yeyixin20041209-png/ESIprojectgroup5/3D/palm.stl

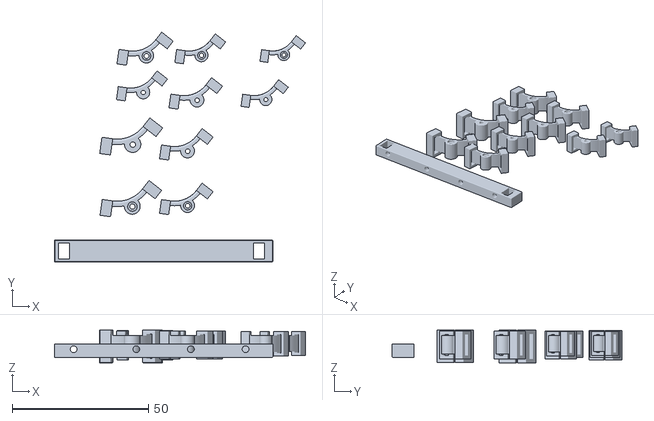
[picture p1: CAD file, 2026-11-02]
3D/palm.stl
92.0 x 84.2 x 12.0
