yeyixin20041209-png/ESIprojectgroup5/motor base for nema-17.stl

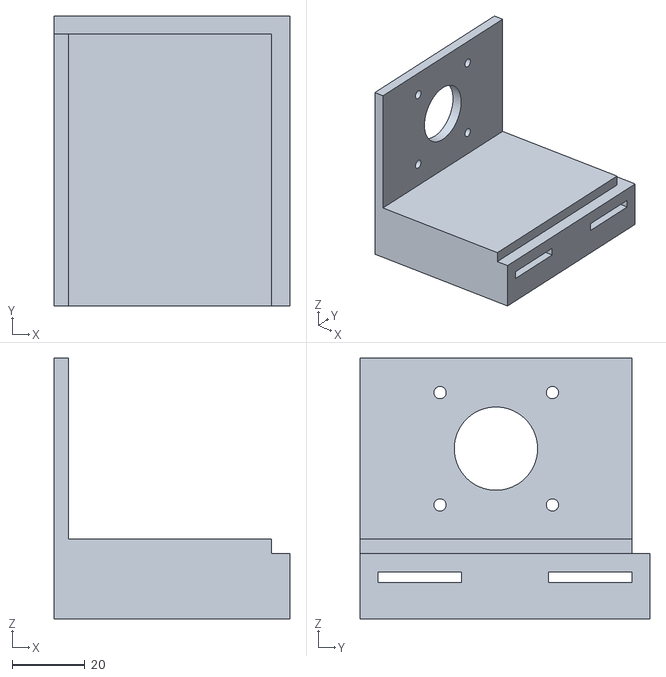
[picture p2: CAD file, 2026-11-02]
motor base for nema-17.stl
65.0 x 80.0 x 72.0
