yeyixin20041209-png/ESIprojectgroup5/spool.stl

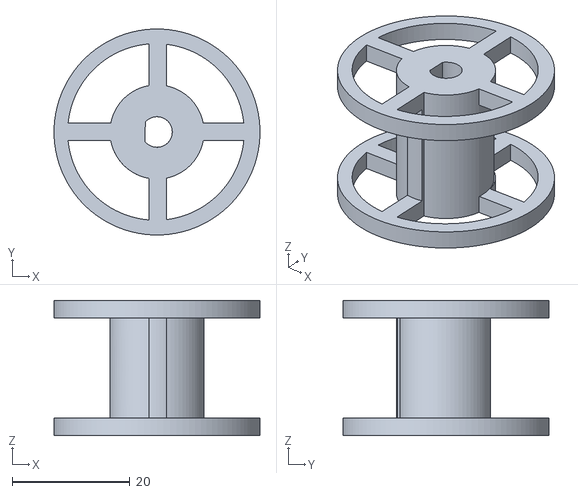
[picture p3: CAD file, 2026-11-02]
spool.stl
35.0 x 35.0 x 23.0
