yeyixin20041209-png/ESIprojectgroup5/battery base.stl

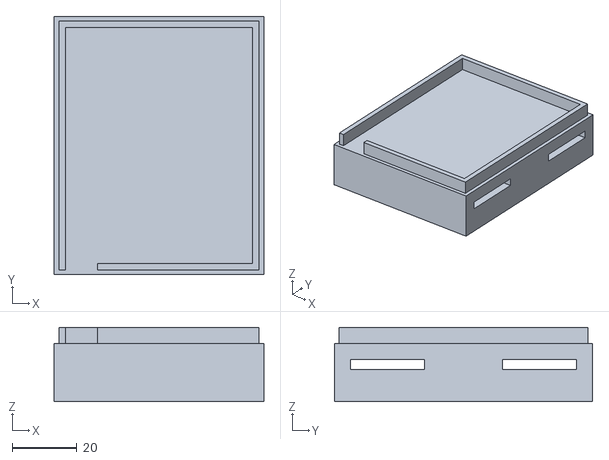
[picture p4: CAD file, 2026-11-02]
battery base.stl
65.0 x 80.0 x 23.0
