yeyixin20041209-png/ESIprojectgroup5/pcb/project.kicad_sch

## KiCad design pcb/project.kicad_sch (2026-11-02)

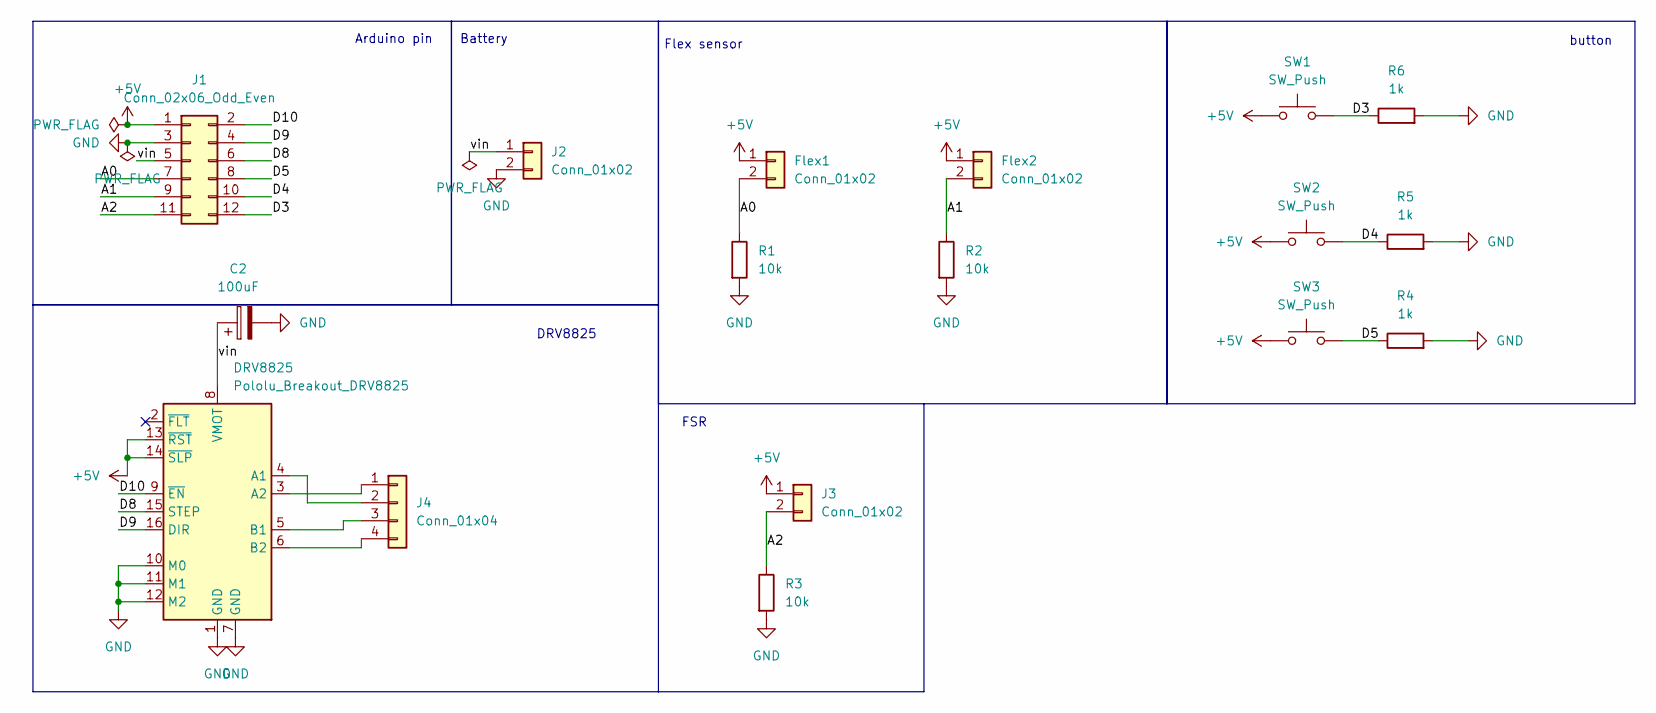
[picture p5: schematic project.kicad_sch]

Parts:
C2: 100uF; CP_Radial_D8.0mm_P3.50mm
DRV8825: Pololu_Breakout_DRV8825; Pololu_Breakout-16_15.2x20.3mm
Flex1, Flex2: Conn_01x02; PinHeader_1x02_P2.54mm_Vertical
J1: Conn_02x06_Odd_Even; PinHeader_2x06_P2.54mm_Vertical
J2, J3: Conn_01x02; PinHeader_1x02_P2.54mm_Vertical
J4: Conn_01x04; PinHeader_1x04_P2.54mm_Vertical
R1, R2, R3: 10k; R_Axial_DIN0207_L6.3mm_D2.5mm_P10.16mm_Horizontal
R4, R5, R6: 1k; R_Axial_DIN0207_L6.3mm_D2.5mm_P10.16mm_Horizontal
SW1, SW2, SW3: SW_Push; SW_PUSH_6mm

Connections:
+5V: DRV8825.13 (~RST), DRV8825.14 (~SLP), Flex1.1, Flex2.1, J1.1, J3.1, SW1.1, SW2.1, SW3.1
A0: Flex1.2, J1.7, R1.1
A1: Flex2.2, J1.9, R2.1
A2: J1.11, J3.2, R3.1
D3: J1.12, R6.1, SW1.2
D4: J1.10, R5.1, SW2.2
D5: J1.8, R4.1, SW3.2
D8: DRV8825.15 (STEP), J1.6
D9: DRV8825.16 (DIR), J1.4
D10: DRV8825.9 (~EN), J1.2
GND: C2.2, DRV8825.1 (GND), DRV8825.7 (GND), DRV8825.10 (M0), DRV8825.11 (M1), DRV8825.12 (M2), J1.3, J2.2, R1.2, R2.2, R3.2, R4.2, R5.2, R6.2
unnamed: DRV8825.3 (A2), J4.1
unnamed: DRV8825.4 (A1), J4.2
unnamed: DRV8825.5 (B1), J4.3
unnamed: DRV8825.6 (B2), J4.4
vin: C2.1, DRV8825.8 (VMOT), J1.5, J2.1

Notes on the sheet:
Arduino pin
Battery
Flex sensor
DRV8825
FSR
button
