yeyixin20041209-png/ESIprojectgroup5/(commit log)

2026-10-02 Require both flex sensors to reach the grasp threshold
2026-10-02 Require straight fingers before rearming a grasp
2026-10-17 improve in homing logic
2026-10-20 cite calibration
2026-11-02 PCB design
    Added the KiCad project files for the assistive grasping glove, including:
    - Circuit schematic (.kicad_sch) with sensor interfaces, DRV8825 motor driver, control buttons and power connections.
    - Two-layer PCB layout (.kicad_pcb) integrating the electronic components and external connectors.
    - KiCad project configuration (.kicad_pro).
    The design integrates the flex sensors, FSR contact sensor, ATmega328P control connections and stepper motor driver into a single PCB for system assembly.
2026-11-02 Add STL files for 3D-printed glove components
    Add four STL files for the assistive grasping glove:
    - battery base.stl: battery mounting base
    - motor base for nema-17.stl: NEMA17 motor mounting bracket
    - palm.stl: palm-side tendon guide
    - spool.stl: tendon winding spool
2026-11-02 Rename battery base.stl to pcb/battery base.stl
2026-11-02 Rename battery base.stl to battery base.stl
2026-11-02 Rename motor base for nema-17.stl to 3D/motor base for nema-17.stl
